Deltamaster64/Visoka_greda/3d_printani _deli/nosilec_relay.SLDASM

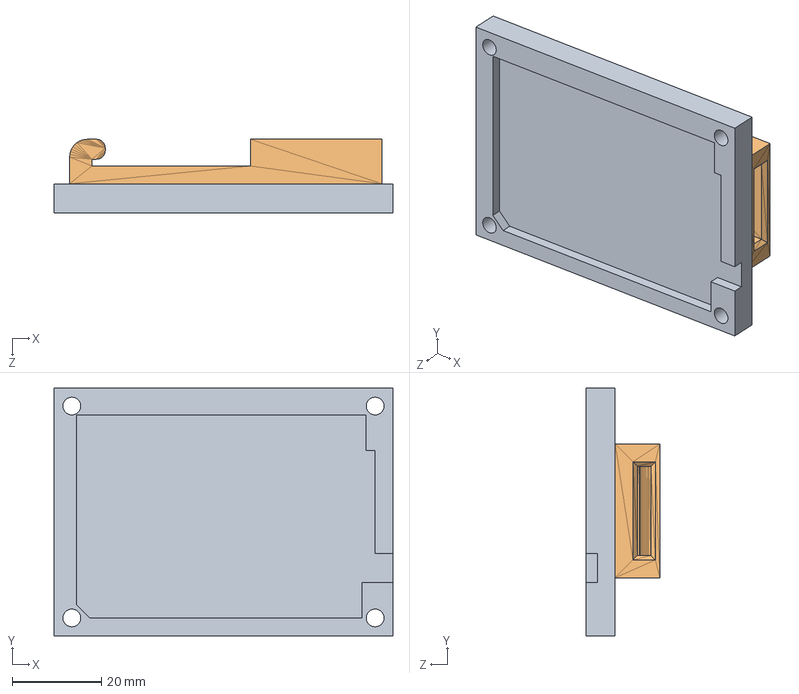
[picture p20: CAD file, 2022-12-07]
3d_printani _deli/nosilec_relay.SLDASM
76.0 x 55.5 x 16.5 mm
relay
din_nosilec
