Deltamaster64/Visoka_greda/3d_printani _deli/nosilec_napajalnikov.SLDASM

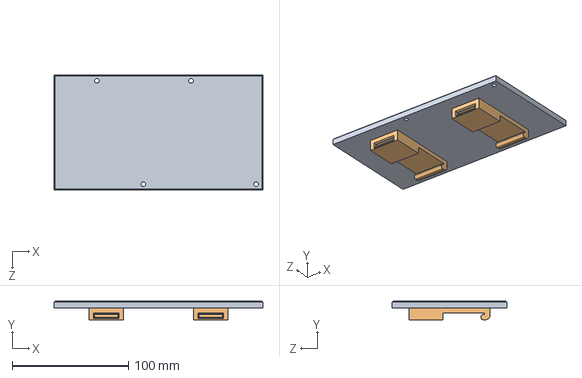
[picture p21: CAD file, 2022-12-07]
3d_printani _deli/nosilec_napajalnikov.SLDASM
180.0 x 16.0 x 99.0 mm
podstavek_napajalniki
din_nosilec x 2
