Deltamaster64/Visoka_greda/3d_printani _deli/nosilec_esp32.SLDASM

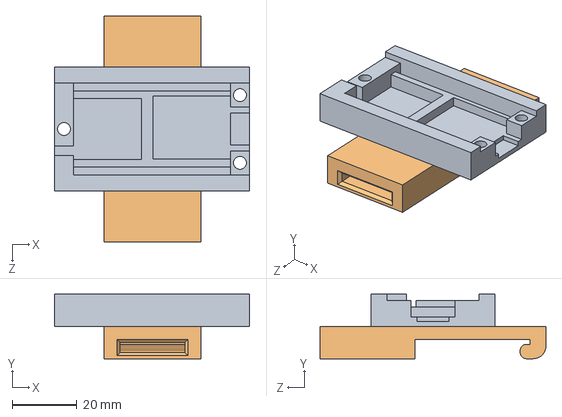
[picture p22: CAD file, 2022-12-07]
3d_printani _deli/nosilec_esp32.SLDASM
60.5 x 20.0 x 70.0 mm
nosilec_esp32
din_nosilec
