Deltamaster64/Visoka_greda/3d_printani _deli/nosilec_reley.SLDASM

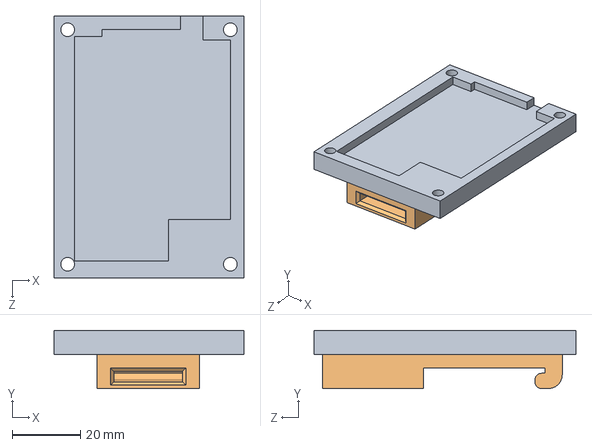
[picture p23: CAD file, 2022-12-07]
3d_printani _deli/nosilec_reley.SLDASM
55.5 x 17.0 x 76.5 mm
podstavek_reley
din_nosilec
