Deltamaster64/Visoka_greda/3d_printani _deli/DHT22_pokrov.SLDPRT

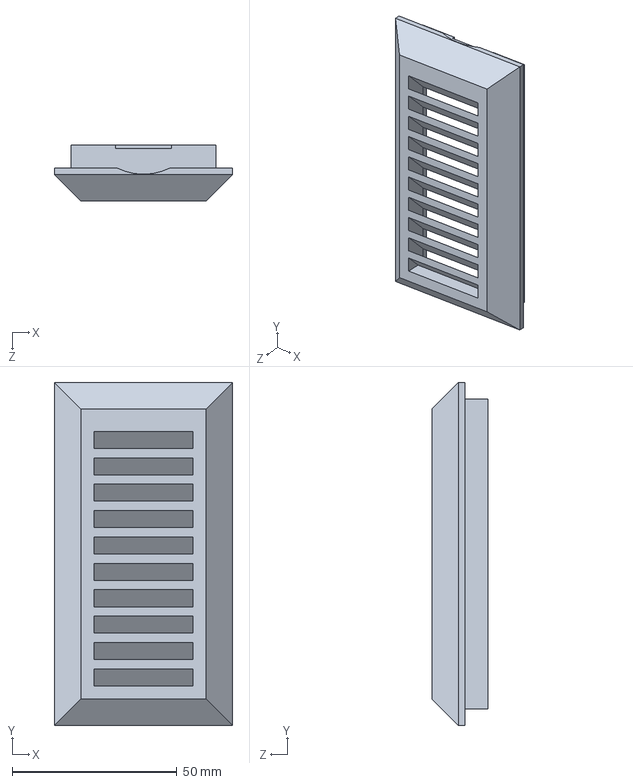
[picture p24: CAD file, 2022-12-07]
3d_printani _deli/DHT22_pokrov.SLDPRT
54.0 x 104.0 x 17.0 mm
