Deltamaster64/Visoka_greda/3d_printani _deli/nosilec_relay - relay-1.STL

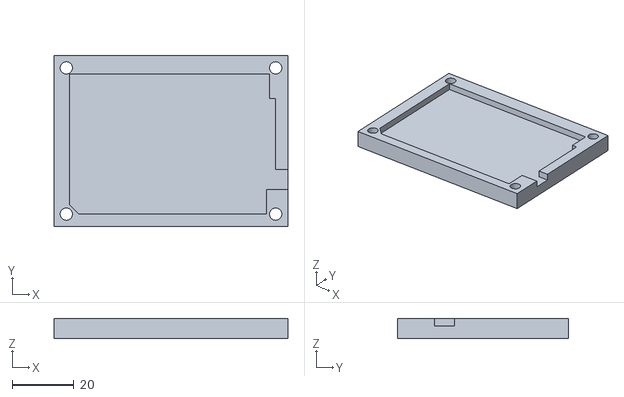
[picture p25: CAD file, 2022-12-07]
3d_printani _deli/nosilec_relay - relay-1.STL
76.0 x 55.5 x 6.50
