Deltamaster64/Visoka_greda/3d_printani _deli/DHT22.SLDPRT

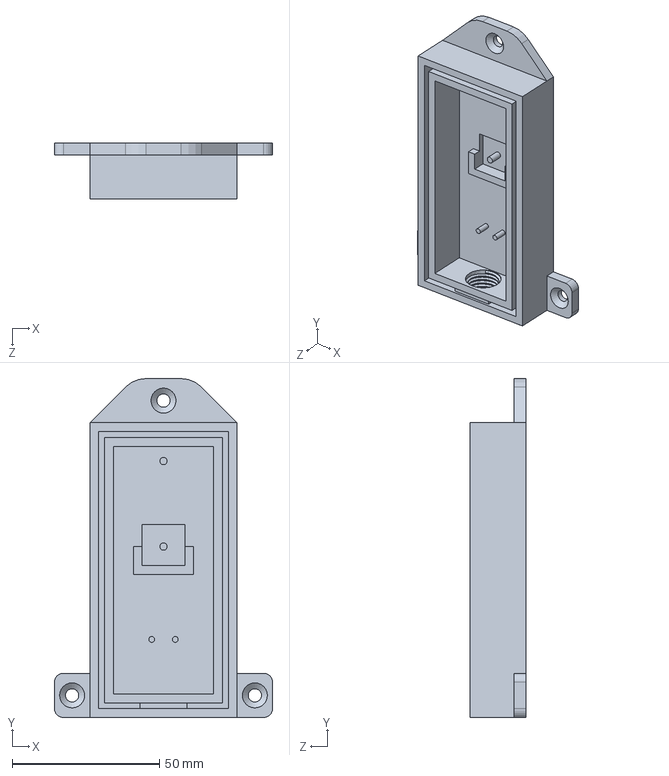
[picture p26: CAD file, 2022-12-07]
3d_printani _deli/DHT22.SLDPRT
74.0 x 115.0 x 19.0 mm
