Deltamaster64/Visoka_greda/3d_printani _deli/podstavek_napajalniki.SLDPRT

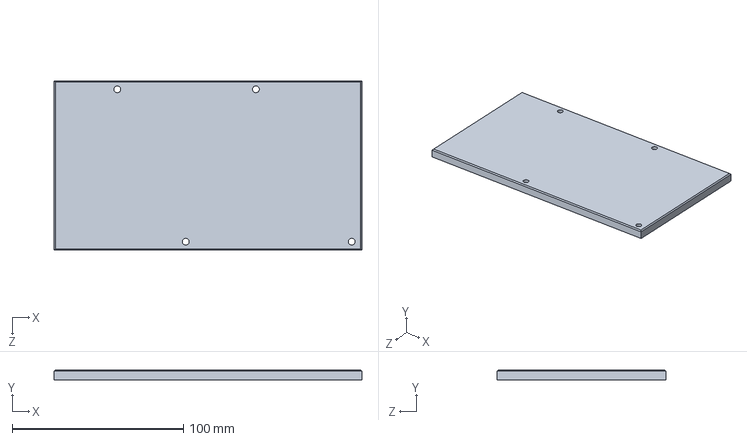
[picture p27: CAD file, 2022-12-07]
3d_printani _deli/podstavek_napajalniki.SLDPRT
180.0 x 6.00 x 99.0 mm
