Deltamaster64/Visoka_greda/3d_printani _deli/pin.SLDPRT

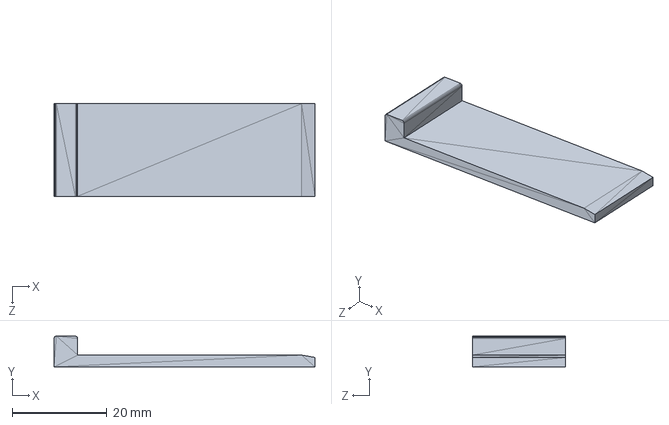
[picture p28: CAD file, 2022-12-07]
3d_printani _deli/pin.SLDPRT
55.0 x 6.50 x 19.5 mm
