Deltamaster64/Visoka_greda/3d_printani _deli/podstavek_reley.SLDPRT

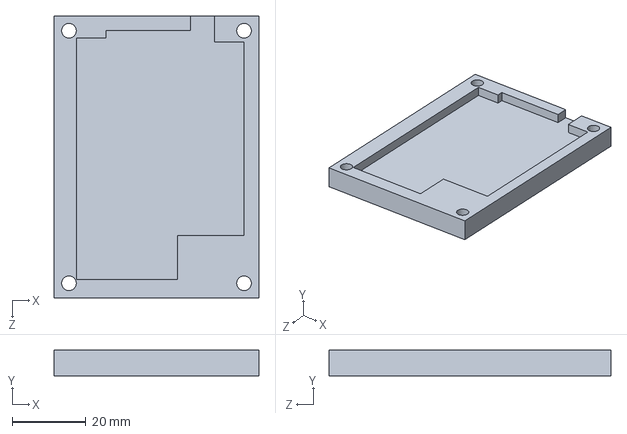
[picture p29: CAD file, 2022-12-07]
3d_printani _deli/podstavek_reley.SLDPRT
55.5 x 7.00 x 76.5 mm
