Deltamaster64/Visoka_greda/3d_printani _deli/din_nosilec.SLDPRT

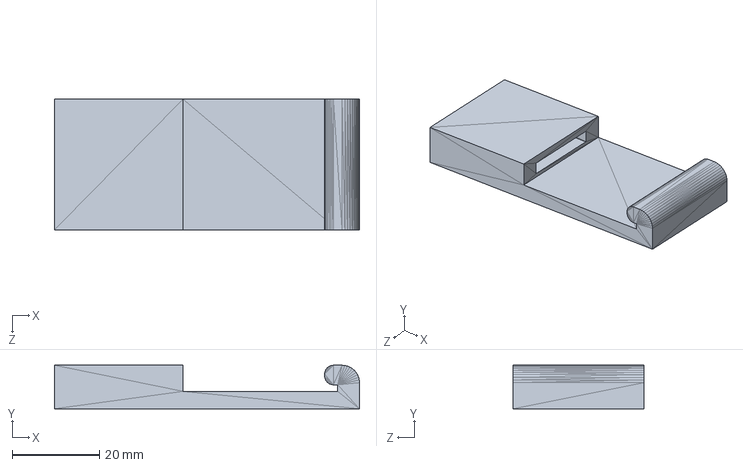
[picture p30: CAD file, 2022-12-07]
3d_printani _deli/din_nosilec.SLDPRT
70.0 x 10.0 x 30.0 mm
