Deltamaster64/Visoka_greda/3d_printani _deli/senzor_dez.SLDPRT

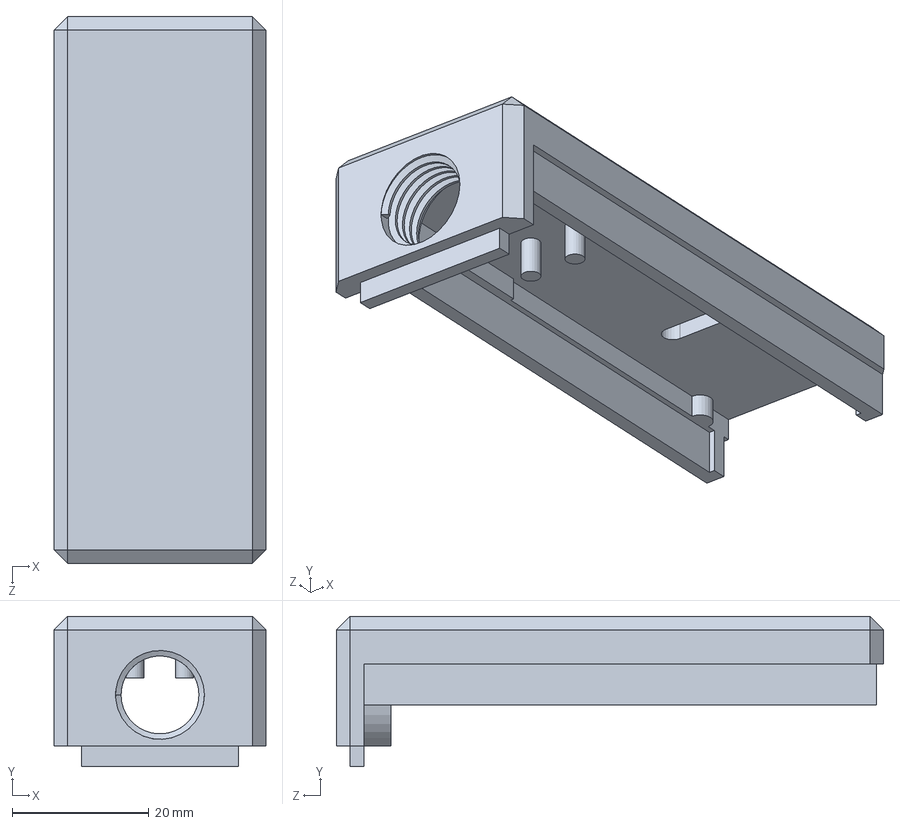
[picture p31: CAD file, 2022-12-07]
3d_printani _deli/senzor_dez.SLDPRT
31.0 x 22.0 x 80.0 mm
