Deltamaster64/Visoka_greda/3d_printani _deli/DIN_DEFAULT.SLDPRT

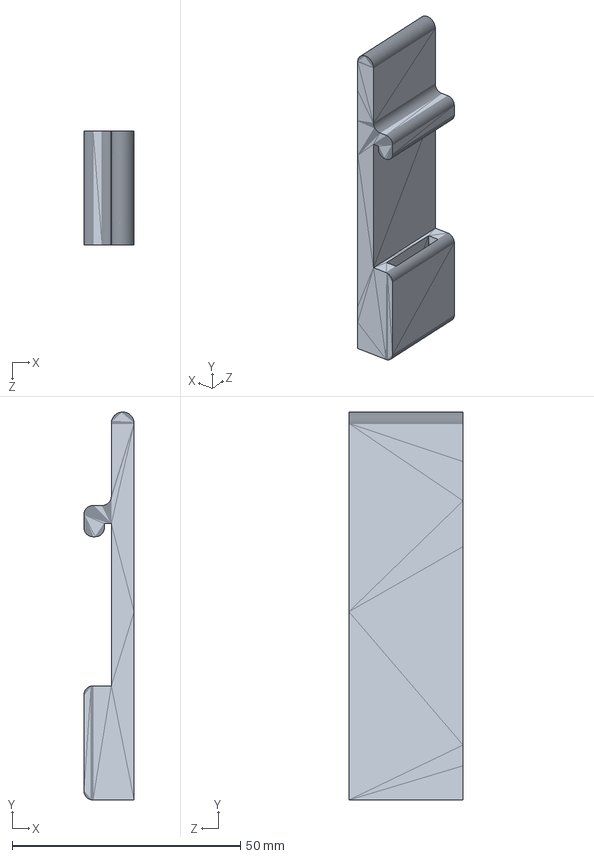
[picture p32: CAD file, 2022-12-07]
3d_printani _deli/DIN_DEFAULT.SLDPRT
11.0 x 85.0 x 25.0 mm
