Deltamaster64/Visoka_greda/3d_printani _deli/pokrov_senzor_dez.SLDPRT

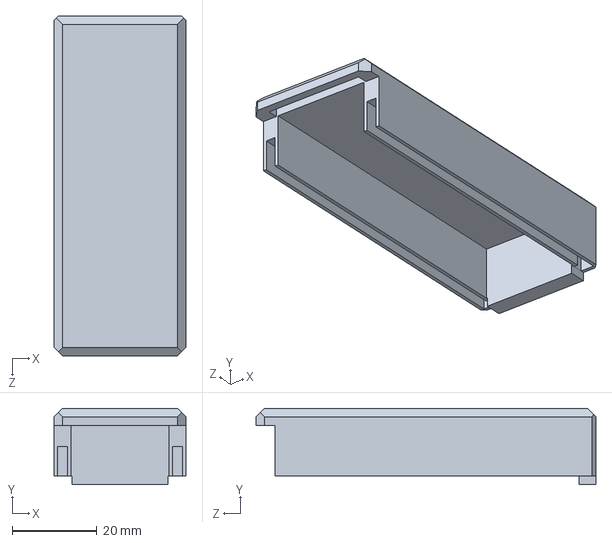
[picture p33: CAD file, 2022-12-07]
3d_printani _deli/pokrov_senzor_dez.SLDPRT
31.0 x 18.0 x 80.0 mm
