Deltamaster64/Visoka_greda/3d_printani _deli/srauf.SLDPRT

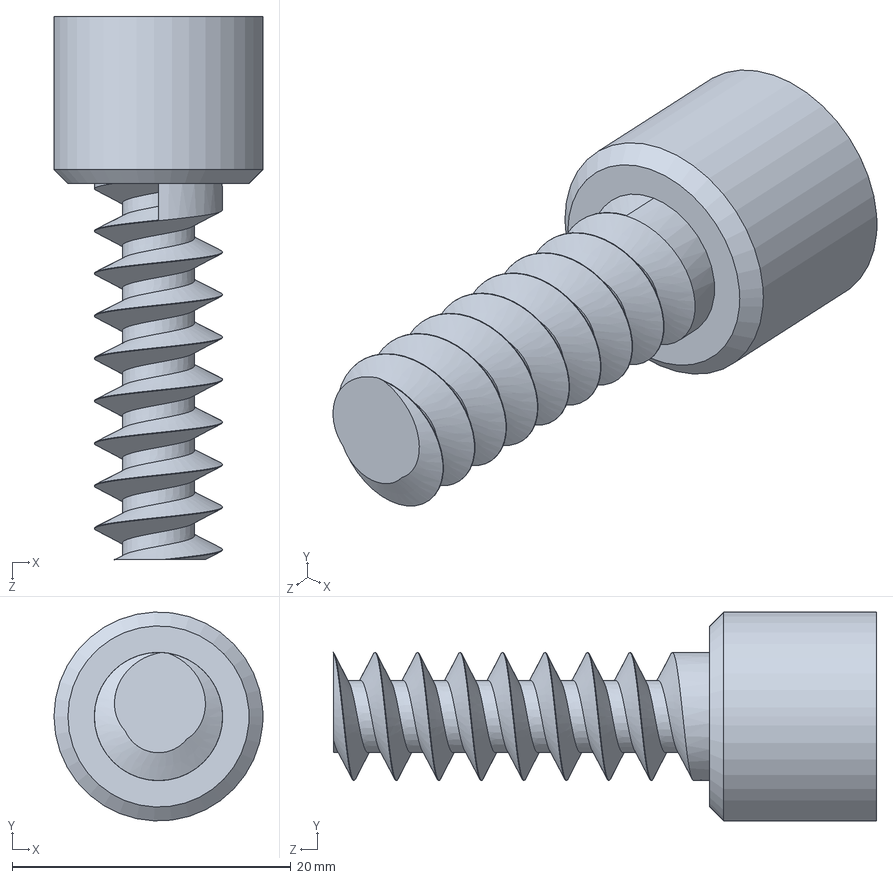
[picture p34: CAD file, 2022-12-07]
3d_printani _deli/srauf.SLDPRT
15.0 x 15.0 x 39.0 mm
