Deltamaster64/Visoka_greda/3d_printani _deli/test.SLDPRT

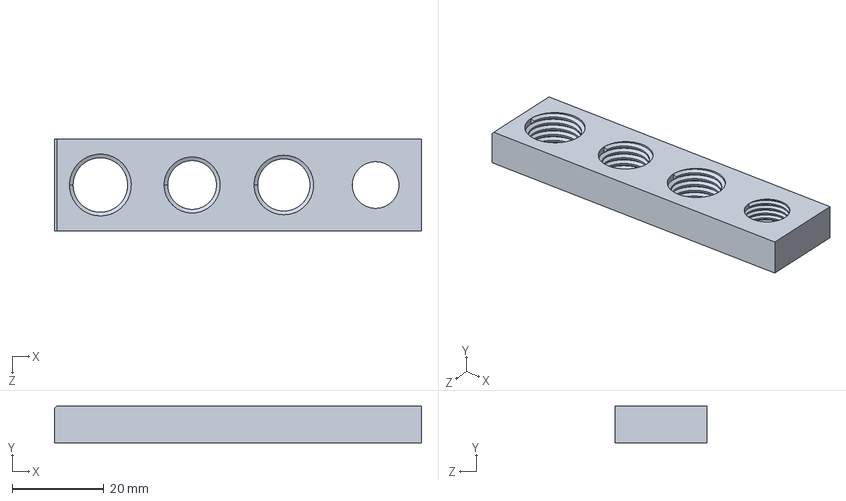
[picture p35: CAD file, 2022-12-07]
3d_printani _deli/test.SLDPRT
80.0 x 8.00 x 20.0 mm
