Deltamaster64/Visoka_greda/3d_printani _deli/nosilec_vticnica.SLDPRT

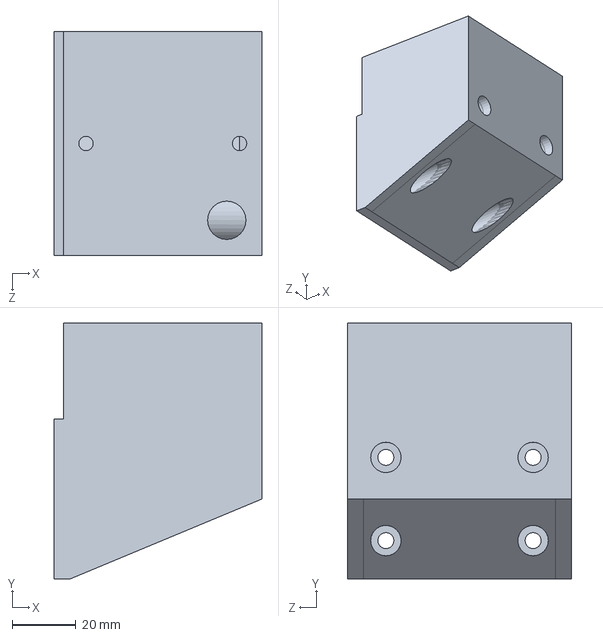
[picture p36: CAD file, 2022-12-07]
3d_printani _deli/nosilec_vticnica.SLDPRT
65.0 x 80.0 x 70.0 mm
