Deltamaster64/Visoka_greda/3d_printani _deli/pin_small.SLDPRT

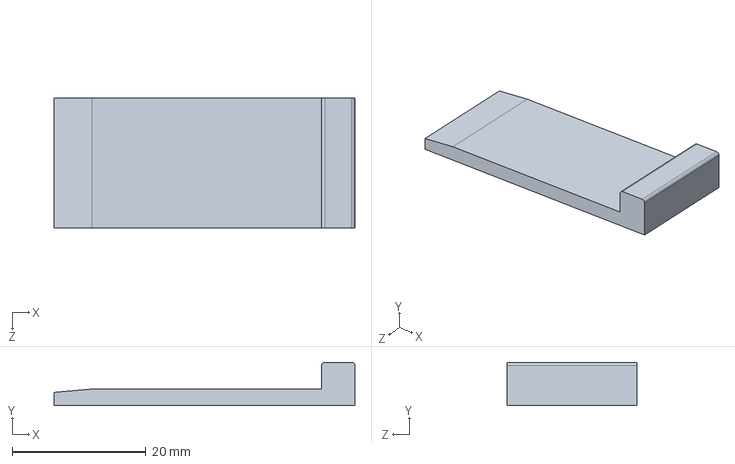
[picture p37: CAD file, 2022-12-07]
3d_printani _deli/pin_small.SLDPRT
45.0 x 6.50 x 19.5 mm
