Deltamaster64/Visoka_greda/(list of files, cad)

Other CAD files:
3d_printani _deli/relay.SLDPRT
3d_printani _deli/nosilec_relay - din_nosilec-1.STL
3d_printani _deli/din_nosilec_esp32.SLDPRT
3d_printani _deli/nosilec_relay - din_nosilec-1-1.STL
3d_printani _deli/DIN_DEFAULT1.SLDPRT
3d_printani _deli/nosilec_relay - relay-1-1.STL
3d_printani _deli/DHT22.STL
3d_printani _deli/DHT22_pokrov.STL
3d_printani _deli/DIN_DEFAULT.stl
3d_printani _deli/din_nosilec.STL
3d_printani _deli/din_nosilec_esp32.STL
3d_printani _deli/nosilec_esp32.SLDPRT
3d_printani _deli/nosilec_napajalnikov.SLDPRT
3d_printani _deli/nosilec_napajalnikov.STL
3d_printani _deli/nosilec_relay.SLDPRT
3d_printani _deli/nosilec_relay.STL
3d_printani _deli/nosilec_reley.SLDPRT
3d_printani _deli/nosilec_reley.STL
3d_printani _deli/nosilec_vticnica.STL
3d_printani _deli/pin.STL
3d_printani _deli/pin_small.STL
3d_printani _deli/pokrov_senzor_dez.STL
3d_printani _deli/senzor_dez.STL
3d_printani _deli/srauf.STL
3d_printani _deli/test.STL
