Deltamaster64/Visoka_greda/Programi/DHT22/DHT22.ino

#include "DHT.h"

#define DHTPIN 13
#define DHTTYPE DHT22
DHT dht(DHTPIN, DHTTYPE);

void setup() {
  
  Serial.begin(115200);
  dht.begin();

}

void loop() {
  
  delay(1000);
  
  float h = dht.readHumidity();
  float t = dht.readTemperature();


  Serial.print(F("Humidity: "));
  Serial.print(h);
  Serial.print(F("%  Temperature: "));
  Serial.print(t);
  Serial.println(F("°C "));

  
}
